icepixie071/UUV_ECU_Shield_Nucleo-144/(commit log)

2026-08-02 初回コミット．
    [ROV_ECU_shield_nucleo.kicad_pcb, ROV_ECU_shield_nucleo.kicad_sch]
2026-08-02 下記設計方針を定義．設計に反映． ・秋月電子での入手性を優先．（ZHコネクタ，LDO等） ・IMUは6軸（MPU6500は新規非推奨だが量産active） ・IMUメイン用途はレート制御・サブ用途が姿勢制御 ・2次側3.3V生成方法はひとまず秋月の高耐圧LDOとする．
    設計TODO：
    ・ヒューズパッケージ未決定．
    [ROV_ECU_shield_nucleo.kicad_pcb, ROV_ECU_shield_nucleo.kicad_sch]
2026-08-09 ・kicad ver. 10.05に変更． ・現在の設計でコミット． ・KiCad Routing Toolsプラグインをインストール．
    [ROV_ECU_shield_nucleo.kicad_pcb, ROV_ECU_shield_nucleo.kicad_sch]
2026-09-01 ・sch 誤接続修正（I2C1_SCL/SPI1_SCK）修正． ・BNO085 H_INTN端子を外部割込み端子へ接続． ・A/Wレイアウトブラッシュアップ．
    [ROV_ECU_shield_nucleo.kicad_pcb, ROV_ECU_shield_nucleo.kicad_sch]
2026-09-12 試作完了．発注．
    [ROV_ECU_shield_nucleo.kicad_pcb, ROV_ECU_shield_nucleo.kicad_sch]
2026-09-12 bomをコミット．
